luongtranpt/WSN/(list of files, drawings)

Other design files:
Hardware/Gateway_WSN_2023_1/Gateway_WSN_2023_1.PrjPcb
Hardware/Gateway_WSN_2023_1/HMI.SchDoc
Hardware/Gateway_WSN_2023_1/LORA.SchDoc
Hardware/Gateway_WSN_2023_1/MAIN.SchDoc
Hardware/Gateway_WSN_2023_1/MCU.SchDoc
Hardware/Gateway_WSN_2023_1/PCB2.PcbDoc
Hardware/Gateway_WSN_2023_1/POWER.SchDoc
Hardware/Node_WSN_2023_1/[1]MCU.SchDoc
Hardware/Node_WSN_2023_1/[3]SENSOR.SchDoc
Hardware/Node_WSN_2023_1/[4]LORA.SchDoc
Hardware/Node_WSN_2023_1/[5]LCD.SchDoc
Hardware/Node_WSN_2023_1/PCB1.PcbDoc
Hardware/Node_WSN_2023_1/PCB_Project.PrjPcb
Hardware/Node_WSN_2023_1/Sheet1.SchDoc
