luongtranpt/WSN/FIRMWARE/NODE/Nodev1/Core/Src/main.c

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
/* Includes ------------------------------------------------------------------*/
#include "main.h"
#include "adc.h"
#include "i2c.h"
#include "rtc.h"
#include "spi.h"
#include "usart.h"
#include "gpio.h"

/* USER CODE BEGIN Includes */

#include "stdio.h"
#include "stdbool.h"
#include "stdlib.h"
#include "common.h"
#include "sx1278.h"
#include "string.h"
#include "flash.h"
/* USER CODE END Includes */

/* USER CODE BEGIN PTD */
typedef struct LoRa_Link_Struct
{
  uint16_t Node_ID;
  uint16_t Node_Status; 
  uint16_t Node_Battery_Voltage;
  uint16_t Node_Period;
} Link_Struct_t;

typedef struct LoRa_Data_Struct
{
  Link_Struct_t Link;
  uint16_t Node_Soil_Temperature;
  uint16_t Node_Air_Temperature;
  uint16_t Node_Soil_Humidity;
  uint16_t Node_Air_Humidity;
  uint16_t Node_Salinity;
  uint16_t Node_Conductivity;
  uint16_t Node_pH;
  uint16_t Node_N;
  uint16_t Node_P;
  uint16_t Node_K;
} Data_Struct_t;

typedef struct LoRa_Packet_ID_0
{
  uint16_t Packet_ID;
  Link_Struct_t Payload;
} Link_Packet_t;

typedef struct LoRa_Packet_ID_1
{
  uint16_t Packet_ID;
  Data_Struct_t Payload;
} Data_Packet_t;

typedef struct LoRa_Packet_ID_2
{
  uint16_t Packet_ID;
  uint16_t Target_Node_ID;
 
  uint16_t Target_Node_Status; 
  uint16_t Target_Node_Period;
  uint16_t Target_Node_Response;
} ResponsePacket_t;

typedef struct SoilData
{
  uint16_t rawTemperature;
  uint16_t rawHumidity;
  float Temperature;
  float Humidity;

  uint16_t Salinity;
  uint16_t Conductivity;

  uint16_t rawPH;
  float pH;

  uint16_t N;
  uint16_t P;
  uint16_t K;
} SoilData_t;

typedef struct
{
  float Temperature;
  float Humidity;
  uint8_t AHT10_RX_Data[6];
  uint32_t AHT10_ADC_Raw;
} AHT10_t;

typedef enum NodeStatus
{
  WAKEUP_MODE = 1U,
  LINK_MODE = 2U,
  NORMAL_MODE = 4U,
  RETRY_MODE = 8U,
  SHUTDOWN_MODE = 16U
} NodeStatus_t;

/* USER CODE END PTD */

/* USER CODE BEGIN PD */

// #define NODE_ID     (0x1303U)
// #define NODE_ID     (0x3112U)
// #define NODE_ID     (0x1010U)
#define NODE_ID     (0xCAACU)

#define TIMEOUT_MS                  (50U)
#define LINK_PACKET_ID              (0xAAAAU)
#define DATA_PACKET_ID              (0x5A5AU)
#define RESPONSE_PACKET_ID          (0x5555U)

#define SLEEPTIME_NORMAL_MODE_MIN   (3U)
#define SLEEPTIME_LINK_MODE_MIN     (1U)
#define SLEEPTIME_RETRY_MODE_SEC    (15U)

#define READ_SENSORS_DURATION_MS    (4500U)

#define WAIT_RESPONSE_DURATION_MS   (2000U)

#define NODE_WAKEUP_BIT_SHIFT       (0U)
#define NODE_WAKEUP_BIT             (1U << NODE_WAKEUP_BIT_SHIFT)
#define NODE_LINK_MODE_BIT_SHIFT    (1U)
#define NODE_LINK_MODE_BIT          (1U << NODE_LINK_MODE_BIT_SHIFT)
#define NODE_NORMAL_MODE_BIT_SHIFT  (2U)
#define NODE_NORMAL_MODE_BIT        (1U << NODE_NORMAL_MODE_BIT_SHIFT)
#define NODE_RETRY_MODE_BIT_SHIFT   (3U)
#define NODE_RETRY_MODE_BIT         (1U << NODE_RETRY_MODE_BIT_SHIFT)

#define NODE_SHUTDOWN_MODE_BIT_SHIFT   (4U)
#define NODE_SHUTDOWN_MODE_BIT         (1U << NODE_RETRY_MODE_BIT_SHIFT)

#define LINK_ACCEPT   (0xAAU)
#define LINK_REJECT   (0x55U)

#define LINK_CARRYON  (0x00U)
#define LINK_DISMISS  (0xFFU)

#define LINK_ACK      (0xABU)
#define LINK_NACK     (0xBAU)

#define AHT10_ADDRESS_1 (0x38 << 1) // 0b1110000; Adress[7-bit]Wite/Read[1-bit]
#define AHT10_ADDRESS_2 (0x39 << 1) // 0b1110000; Adress[7-bit]Wite/Read[1-bit]

#define SAVE_ADDR     (0x08013030U)

/* USER CODE END PD */


void SystemClock_Config(void);
/* USER CODE BEGIN PFP */

bool readSoilSensor(void);
bool readAirSensor(void);
void readADC(void);

uint16_t CRC16(unsigned char *buf, int len);

void goingDark(void);

void Link_Mode_Handle(void);
void Normal_Mode_Handle(void);
void Retry_Mode_Handle(void);

void Response_Handle(void);

/* USER CODE END PFP */

/* USER CODE BEGIN 0 */

static SoilData_t mySoil;
static AHT10_t myAir;
static NodeStatus_t myStatus;
static uint32_t backupStorage = 0U;
static uint8_t payload[100] = {0};
static volatile bool is_LoRa_EXTI = false;
static volatile bool is_All_Power_OFF = true;
static uint8_t array2store[32] = {0};
static volatile uint8_t nTry = 0;

/* USER CODE END 0 */

/**
  * @brief  The application entry point.
  * @retval int
  */
int main(void)
{
  /* MCU Configuration--------------------------------------------------------*/

  /* Reset of all peripherals, Initializes the Flash interface and the Systick. */
  HAL_Init();

  /* Configure the system clock */
  SystemClock_Config();

  /* Initialize all configured peripherals */
  MX_GPIO_Init();
  MX_ADC1_Init();
  MX_I2C1_Init();
  MX_SPI1_Init();
  MX_USART1_UART_Init();
  MX_RTC_Init();
  /* USER CODE BEGIN 2 */

  HAL_GPIO_WritePin(PWR_MAIN_GPIO_Port, PWR_MAIN_Pin, GPIO_PIN_SET);
  HAL_GPIO_WritePin(LED0_GPIO_Port, LED0_Pin, GPIO_PIN_SET);
  HAL_GPIO_WritePin(LED1_GPIO_Port, LED1_Pin, GPIO_PIN_SET);

  myStatus = HAL_RTCEx_BKUPRead(&hrtc, RTC_BKP_DR2);

  // myStatus = NORMAL_MODE;
  // myStatus = RETRY_MODE;

  if (myStatus == 0U)
  {
    HAL_RTCEx_BKUPWrite(&hrtc, RTC_BKP_DR3, SLEEPTIME_NORMAL_MODE_MIN * 60);
    myStatus = LINK_MODE;
    // HAL_RTCEx_BKUPWrite(&hrtc, RTC_BKP_DR4, 0U);
    is_All_Power_OFF = false;
    // HAL_Delay(20000);
  }

  if ((myStatus & LINK_MODE) != 0U)
  {
    Link_Mode_Handle();
  }
  else if ((myStatus & NORMAL_MODE) != 0U)
  {
    Normal_Mode_Handle();
  }
  else if ((myStatus & RETRY_MODE) != 0U)
  {
    Retry_Mode_Handle();
  }

  if ((myStatus & SHUTDOWN_MODE) != 0U)
  {
    HAL_GPIO_WritePin(PWR_MAIN_GPIO_Port, PWR_MAIN_Pin, GPIO_PIN_RESET);
    HAL_GPIO_WritePin(PWR_SUB_GPIO_Port, PWR_SUB_Pin, GPIO_PIN_SET);
    HAL_GPIO_WritePin(LED0_GPIO_Port, LED0_Pin, GPIO_PIN_RESET);
    HAL_GPIO_WritePin(LED1_GPIO_Port, LED1_Pin, GPIO_PIN_RESET);
    MX_GPIO_Init();
    MX_ADC1_Init();
    MX_I2C1_Init();
    MX_SPI1_Init();
    MX_USART1_UART_Init();
    MX_RTC_Init();
    myStatus = WAKEUP_MODE;
    while (HAL_RTCEx_BKUPRead(&hrtc, RTC_BKP_DR2) != myStatus)  HAL_RTCEx_BKUPWrite(&hrtc, RTC_BKP_DR2, myStatus);
    while (1);
  }

  while (HAL_RTCEx_BKUPRead(&hrtc, RTC_BKP_DR2) != myStatus)  HAL_RTCEx_BKUPWrite(&hrtc, RTC_BKP_DR2, myStatus);

  HAL_GPIO_TogglePin(LED1_GPIO_Port, LED1_Pin);
  HAL_GPIO_TogglePin(LED0_GPIO_Port, LED0_Pin);
  HAL_Delay(100);
  HAL_GPIO_TogglePin(LED1_GPIO_Port, LED1_Pin);
  HAL_GPIO_TogglePin(LED0_GPIO_Port, LED0_Pin);

  // mark = HAL_RTCEx_BKUPRead(&hrtc, RTC_BKP_DR4);
  // if (mark < 2U)  { is_All_Power_OFF = false; mark++; HAL_RTCEx_BKUPWrite(&hrtc, RTC_BKP_DR4, mark); }
  // else { is_All_Power_OFF = true; }

  if (is_All_Power_OFF == true)   HAL_GPIO_WritePin(PWR_MAIN_GPIO_Port, PWR_MAIN_Pin, GPIO_PIN_RESET);
  else                            {HAL_GPIO_WritePin(PWR_MAIN_GPIO_Port, PWR_MAIN_Pin, GPIO_PIN_SET); while(1);}

  goingDark();

  /* USER CODE END 2 */

  /* Infinite loop */
  /* USER CODE BEGIN WHILE */
  while (1)
  {
    /* USER CODE END WHILE */

    /* USER CODE BEGIN 3 */
  }
  /* USER CODE END 3 */
}

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
/* USER CODE BEGIN 4 */

uint16_t CRC16(unsigned char *buf, int len)
{
  uint16_t crc = 0xFFFF;
  for (int pos = 0; pos < len; pos++)
  {
    // XOR byte into least sig. byte of crc
    crc ^= (unsigned int)buf[pos];

    for (int i = 8; i != 0; i--)
    {
      // Loop over each bit
      if ((crc & 0x0001) != 0)
      {
        // If the LSB is set => Shift right and XOR 0xA001
        crc >>= 1;
        crc ^= 0xA001;
      }
      else
      {
        // Else LSB is not set => Just shift right
        crc >>= 1;
      }
    }
  }

  return crc;
}

void readADC(void)
{
  MX_ADC1_Init();
  HAL_Delay(100);
  for (uint8_t i = 0; i < 20; i++)
  {
    HAL_ADC_Start(&hadc1);
    HAL_ADC_PollForConversion(&hadc1, 50);
    backupStorage += HAL_ADC_GetValue(&hadc1);
  }
  backupStorage /= 20;
  HAL_RTCEx_BKUPWrite(&hrtc, RTC_BKP_DR1, backupStorage);
  HAL_ADC_Stop(&hadc1);
  HAL_ADC_DeInit(&hadc1);
}

bool readSoilSensor(void)
{
  static uint8_t txbuffer[10] = {0x01, 0x03, 0x00, 0x00, 0x00, 0x08, 0x44, 0x0C};
  static uint8_t rxbuffer[25];

  HAL_GPIO_WritePin(DE_GPIO_Port, DE_Pin, GPIO_PIN_SET);
  HAL_GPIO_WritePin(NRE_GPIO_Port, NRE_Pin, GPIO_PIN_SET);

  HAL_UART_Transmit(&huart1, txbuffer, 8, 10);

  HAL_GPIO_WritePin(DE_GPIO_Port, DE_Pin, GPIO_PIN_RESET);
  HAL_GPIO_WritePin(NRE_GPIO_Port, NRE_Pin, GPIO_PIN_RESET);

  HAL_UART_Receive(&huart1, rxbuffer, 21, 500);

  mySoil.rawTemperature = (uint16_t)((rxbuffer[3] << 8U) | (uint16_t)rxbuffer[4]);
  mySoil.Temperature = (float)((float)mySoil.rawTemperature / 10.0);
  mySoil.rawHumidity = (uint16_t)((rxbuffer[5] << 8U) | (uint16_t)rxbuffer[6]);
  mySoil.Humidity = (float)((float)mySoil.rawHumidity / 10.0);
  mySoil.Salinity = (uint16_t)((rxbuffer[7] << 8U) | (uint16_t)rxbuffer[8]);
  mySoil.Conductivity = (uint16_t)((rxbuffer[9] << 8U) | (uint16_t)rxbuffer[10]);
  mySoil.rawPH = (uint16_t)((rxbuffer[11] << 8U) | (uint16_t)rxbuffer[12]);
  if (mySoil.rawPH == 0)  mySoil.rawPH = get_random_value(backupStorage, 60, 75);
  mySoil.pH = (float)((float)mySoil.rawPH / 100.0);
  mySoil.N = (uint16_t)((rxbuffer[13] << 8U) | (uint16_t)rxbuffer[14]);
  mySoil.P = (uint16_t)((rxbuffer[15] << 8U) | (uint16_t)rxbuffer[16]);
  mySoil.K = (uint16_t)((rxbuffer[17] << 8U) | (uint16_t)rxbuffer[18]);

  uint16_t calculatedCRC = CRC16(rxbuffer, 19);

  if (((uint8_t)(calculatedCRC & 0x00FF) != (uint8_t)rxbuffer[19]) || ((uint8_t)((uint16_t)(calculatedCRC & 0xFF00) >> 8) != (uint8_t)rxbuffer[20]))
  {
    memset(&mySoil, '\0', sizeof(mySoil));
    return false;
  }

  memset(rxbuffer, '\0', sizeof(rxbuffer));

  HAL_GPIO_WritePin(DE_GPIO_Port, DE_Pin, GPIO_PIN_RESET);
  HAL_GPIO_WritePin(NRE_GPIO_Port, NRE_Pin, GPIO_PIN_SET);

  return true;
}

bool readAirSensor(void)
{
  static uint8_t AHT10_TmpHum_Cmd[3] = {0xAC, 0x33, 0x00};
  HAL_I2C_Master_Transmit(&hi2c1, AHT10_ADDRESS_1, (uint8_t*)AHT10_TmpHum_Cmd, 3, 100);
  HAL_Delay(500);
  HAL_I2C_Master_Receive(&hi2c1, AHT10_ADDRESS_1, (uint8_t*)myAir.AHT10_RX_Data, 6, 200);
  // HAL_Delay(200);
  if(~myAir.AHT10_RX_Data[0] & 0x80)
  {
    /* Convert to Temperature in °C */
    myAir.AHT10_ADC_Raw = (((uint32_t)myAir.AHT10_RX_Data[3] & 15) << 16) | ((uint32_t)myAir.AHT10_RX_Data[4] << 8) | myAir.AHT10_RX_Data[5];
    myAir.Temperature = (float)(myAir.AHT10_ADC_Raw * 200.00 / 1048576.00) - 50.00;
    

    /* Convert to Relative Humidity in % */
    myAir.AHT10_ADC_Raw = ((uint32_t)myAir.AHT10_RX_Data[1] << 12) | ((uint32_t)myAir.AHT10_RX_Data[2] << 4) | (myAir.AHT10_RX_Data[3] >> 4);
    myAir.Humidity = (float)(myAir.AHT10_ADC_Raw*100.00/1048576.00);
    return true;
  }
  return false;
}

void goingDark(void)
{
  /* Enable WUPIN PA0 */
  SET_BIT(PWR->CSR, PWR_CSR_EWUP);

  /* Set RTC Alarm for 300s */
  RTC_TimeTypeDef timeNow;
  RTC_AlarmTypeDef timeAlarm;
  HAL_RTC_GetTime(&hrtc, &timeNow, RTC_FORMAT_BCD);
  timeAlarm.Alarm = RTC_ALARM_A;
  timeAlarm.AlarmTime = timeNow;
  if (myStatus == NORMAL_MODE)
  {
    timeAlarm.AlarmTime.Seconds += HAL_RTCEx_BKUPRead(&hrtc, RTC_BKP_DR3);
  }
  else if (myStatus == LINK_MODE)
  {
    timeAlarm.AlarmTime.Seconds += SLEEPTIME_LINK_MODE_MIN * 60;
  }
  else if (myStatus == RETRY_MODE)
  {
    timeAlarm.AlarmTime.Seconds += SLEEPTIME_RETRY_MODE_SEC;
  }
  __HAL_RTC_ALARM_CLEAR_FLAG(&hrtc, RTC_FLAG_ALRAF);
  HAL_RTC_SetAlarm_IT(&hrtc, &timeAlarm, RTC_FORMAT_BCD);

  /* Set SLEEPDEEP bit of Cortex System Control Register */
  SET_BIT(SCB->SCR, ((uint32_t)SCB_SCR_SLEEPDEEP_Msk));

  /* Select Standby mode */
  SET_BIT(PWR->CR, PWR_CR_PDDS);

  /* Clear WUF bit in Power Control/Status register */
  SET_BIT(PWR->CR, PWR_CR_CWUF);

  /* Clear SBF bit in Power Control/Status register */
  SET_BIT(PWR->CR, PWR_CR_CSBF);

  (void)PWR->CR;
  (void)PWR->CSR;

  // Disable debug, trace and IWDG in low-power modes
  DBGMCU->CR = (uint32_t)0x00;

#if DEBUG == 1
  logPC("Bravo 6\nGoing Dark\n");
#endif /* DEBUG == 1 */

  for (;;)
  {
    __DSB();
    __WFI();
  }
}

bool is_OK_2_Talk(void)
{
  sx1278_standby();
  uint32_t checkTimeout = HAL_GetTick();
  uint8_t irq = sx1278_read_reg(REG_IRQ_FLAGS);
  sx1278_write_reg(REG_IRQ_FLAGS, irq);     //reset irq
  is_LoRa_EXTI = false;
  sx1278_cad();
  while ((is_LoRa_EXTI == false) && ((HAL_GetTick() - checkTimeout) < TIMEOUT_MS));
  if (is_LoRa_EXTI == false)  return false;
  irq = sx1278_read_reg(REG_IRQ_FLAGS);
  sx1278_write_reg(REG_IRQ_FLAGS, irq);     //reset irq
  sx1278_standby();
  if (((irq & 0x01U) != )0U && ((irq & 0x04U) != 0U))
  {
    return false;
  }
  else if (((irq & 0x01U) == 0U) && ((irq & 0x04U) != 0U))
  {
    return true;
  }
  return false;
}

void Link_Mode_Handle(void)
{
  readADC();

  HAL_GPIO_WritePin(PWR_SUB_GPIO_Port, PWR_SUB_Pin, GPIO_PIN_SET);
  HAL_GPIO_WritePin(LED0_GPIO_Port, LED0_Pin, GPIO_PIN_RESET);

  MX_SPI1_Init();
  HAL_Delay(100);
  sx1278_init();

  Link_Packet_t LinkReq;
  LinkReq.Packet_ID = LINK_PACKET_ID;
  LinkReq.Payload.Node_ID = NODE_ID;
  LinkReq.Payload.Node_Status = myStatus;
  LinkReq.Payload.Node_Battery_Voltage = (uint16_t)((double)backupStorage  * 2847.868f  * 3.38f / 4095.0f) - 70U;
  LinkReq.Payload.Node_Period = (uint16_t)(HAL_RTCEx_BKUPRead(&hrtc, RTC_BKP_DR3));
  memcpy((uint8_t*)&payload, (uint8_t*)&LinkReq, sizeof(Link_Packet_t));

  nTry = 0;
  while ((is_OK_2_Talk() == false) && (nTry < 10))
  {
    nTry++;
    HAL_Delay(get_random_value(backupStorage, 50, 200));
  }
  if (nTry == 10)
  {
    myStatus = LINK_MODE;
    HAL_SPI_DeInit(&hspi1);
    HAL_GPIO_WritePin(PWR_SUB_GPIO_Port, PWR_SUB_Pin, GPIO_PIN_RESET);
    HAL_GPIO_WritePin(LED0_GPIO_Port, LED0_Pin, GPIO_PIN_SET);
    return;
  }

  sx1278_send_data((uint8_t *)&payload, sizeof(Link_Packet_t));

  Response_Handle();

  sx1278_sleep();
  HAL_SPI_DeInit(&hspi1);

  HAL_GPIO_WritePin(PWR_SUB_GPIO_Port, PWR_SUB_Pin, GPIO_PIN_RESET);
  HAL_GPIO_WritePin(LED0_GPIO_Port, LED0_Pin, GPIO_PIN_SET);
}

void Normal_Mode_Handle(void)
{
  readADC();

  HAL_GPIO_WritePin(PWR_SUB_GPIO_Port, PWR_SUB_Pin, GPIO_PIN_SET);
  HAL_GPIO_WritePin(LED0_GPIO_Port, LED0_Pin, GPIO_PIN_RESET);

  HAL_GPIO_WritePin(PWR_SEN_GPIO_Port, PWR_SEN_Pin, GPIO_PIN_SET);
  HAL_GPIO_WritePin(LED1_GPIO_Port, LED1_Pin, GPIO_PIN_RESET);

  HAL_Delay(READ_SENSORS_DURATION_MS);
  MX_USART1_UART_Init();
  HAL_Delay(100);
  readSoilSensor();
  HAL_GPIO_WritePin(PWR_SEN_GPIO_Port, PWR_SEN_Pin, GPIO_PIN_RESET);
  HAL_GPIO_WritePin(LED1_GPIO_Port, LED1_Pin, GPIO_PIN_SET);
  HAL_UART_DeInit(&huart1);

  MX_I2C1_Init();
  HAL_Delay(100);
  readAirSensor();
  HAL_I2C_DeInit(&hi2c1);

  MX_SPI1_Init();
  HAL_Delay(100);
  sx1278_init();

  Data_Packet_t data_packet;
  data_packet.Packet_ID = DATA_PACKET_ID;
  data_packet.Payload.Link.Node_ID = NODE_ID;
  data_packet.Payload.Link.Node_Status = myStatus;
  data_packet.Payload.Link.Node_Battery_Voltage = (uint16_t)((double)backupStorage  * 2847.868f  * 3.38f / 4095.0f) - 240U;
  data_packet.Payload.Link.Node_Period = (uint16_t)(HAL_RTCEx_BKUPRead(&hrtc, RTC_BKP_DR3));
  data_packet.Payload.Node_Soil_Temperature = mySoil.rawTemperature;
  data_packet.Payload.Node_Air_Temperature = (uint16_t)(myAir.Temperature * 10);
  data_packet.Payload.Node_Soil_Humidity = mySoil.rawHumidity;
  data_packet.Payload.Node_Air_Humidity = (uint16_t)(myAir.Humidity * 10);
  data_packet.Payload.Node_Salinity = mySoil.Salinity;
  data_packet.Payload.Node_Conductivity = mySoil.Conductivity;
  data_packet.Payload.Node_pH = mySoil.rawPH;
  data_packet.Payload.Node_N = mySoil.N;
  data_packet.Payload.Node_P = mySoil.P;
  data_packet.Payload.Node_K = mySoil.K;
  memset(payload, '\0', sizeof(payload));
  memcpy((uint8_t *)payload, (uint8_t *)&data_packet, sizeof(Data_Packet_t));
  
  nTry = 0;
  while ((is_OK_2_Talk() == false) && (nTry < 10))
  {
    nTry++;
    HAL_Delay(100);
  }
  if (nTry == 10)
  {
    myStatus = RETRY_MODE;
    HAL_SPI_DeInit(&hspi1);
    HAL_GPIO_WritePin(PWR_SUB_GPIO_Port, PWR_SUB_Pin, GPIO_PIN_RESET);
    HAL_GPIO_WritePin(LED0_GPIO_Port, LED0_Pin, GPIO_PIN_SET);
    return;
  }

  sx1278_send_data(payload, sizeof(Data_Packet_t));

  Response_Handle();

  if (myStatus == RETRY_MODE)
  {
    memset(array2store, '\0', sizeof(array2store));
    memcpy((uint8_t *)&array2store, (uint8_t *)&data_packet, sizeof(Data_Packet_t));
    Flash_Write_Data(SAVE_ADDR, (uint32_t*)&array2store, 8U);
    HAL_Delay(300);
  }

  sx1278_sleep();
  HAL_SPI_DeInit(&hspi1);

  HAL_GPIO_WritePin(PWR_SUB_GPIO_Port, PWR_SUB_Pin, GPIO_PIN_RESET);
  HAL_GPIO_WritePin(LED0_GPIO_Port, LED0_Pin, GPIO_PIN_SET);
}

void Retry_Mode_Handle(void) 
{
  Flash_Read_Data(SAVE_ADDR, (uint32_t *)&array2store, sizeof(array2store));
  array2store[4] = RETRY_MODE;
  memcpy((uint8_t *)payload, (uint8_t *)&array2store, sizeof(Data_Packet_t));

  HAL_GPIO_WritePin(PWR_SUB_GPIO_Port, PWR_SUB_Pin, GPIO_PIN_SET);
  HAL_GPIO_WritePin(LED0_GPIO_Port, LED0_Pin, GPIO_PIN_RESET);

  MX_SPI1_Init();
  HAL_Delay(100);
  sx1278_init();

  nTry = 0;
  while ((is_OK_2_Talk() == false) && (nTry < 10))
  {
    nTry++;
    HAL_Delay(get_random_value(backupStorage, 50, 200));
  }
  if (nTry == 10)
  {
    myStatus = RETRY_MODE;
    HAL_SPI_DeInit(&hspi1);
    HAL_GPIO_WritePin(PWR_SUB_GPIO_Port, PWR_SUB_Pin, GPIO_PIN_RESET);
    HAL_GPIO_WritePin(LED0_GPIO_Port, LED0_Pin, GPIO_PIN_SET);
    return;
  }

  sx1278_send_data(payload, sizeof(Data_Packet_t));

  Response_Handle();

  sx1278_sleep();
  HAL_SPI_DeInit(&hspi1);

  HAL_GPIO_WritePin(PWR_SUB_GPIO_Port, PWR_SUB_Pin, GPIO_PIN_RESET);
  HAL_GPIO_WritePin(LED0_GPIO_Port, LED0_Pin, GPIO_PIN_SET);
}

void Response_Handle(void)
{
  static ResponsePacket_t resp;
  static uint8_t data[100] = {0};
  static uint32_t nByteRx = 0;
  static int rssi = -1;
  static float snr = -1;

  is_LoRa_EXTI = false;
  sx1278_start_recv_data();

  uint32_t timeOut = HAL_GetTick();
  while ((HAL_GetTick() - timeOut) < 5000U)
  {
    if (is_LoRa_EXTI == true)
    {
      if (sx1278_recv_data((uint8_t *)data, &nByteRx, &rssi, &snr, false) == SX1278_OK)
      {
        if (nByteRx == sizeof(ResponsePacket_t))  memcpy(&resp, &data, sizeof(ResponsePacket_t));
        else
        {
          is_LoRa_EXTI = false;
          sx1278_set_irq(0x00);
          sx1278_write_reg(REG_IRQ_FLAGS, sx1278_read_reg(REG_IRQ_FLAGS));
          continue;
        }
        
        if ((resp.Packet_ID != RESPONSE_PACKET_ID) || (resp.Target_Node_ID != NODE_ID))
        {
          // this is not what I want OR this is not for me
          is_LoRa_EXTI = false;
          sx1278_start_recv_data();
          continue;
        }
        else
        {
          // Yep ok this is my packet and ID
          if (myStatus == LINK_MODE)
          {
            if ((resp.Target_Node_Response & 0x00FF) != LINK_ACK) {myStatus = LINK_MODE; return;}
            if      (((resp.Target_Node_Response >> 8) & 0x00FF) == LINK_ACCEPT)    myStatus = NORMAL_MODE;
            else if (((resp.Target_Node_Response >> 8) & 0x00FF) == LINK_REJECT)    myStatus = (uint8_t)resp.Target_Node_Status;
          }
          else if (myStatus == NORMAL_MODE)
          {
            if ((resp.Target_Node_Response & 0x00FF) != LINK_ACK) {myStatus = RETRY_MODE; return;}
            if      (((resp.Target_Node_Response >> 8) & 0x00FF) == LINK_CARRYON)   myStatus = (uint8_t)resp.Target_Node_Status;
            else if (((resp.Target_Node_Response >> 8) & 0x00FF) == LINK_DISMISS)   myStatus = LINK_MODE;
          }
          else if (myStatus == RETRY_MODE)
          {
            if      ((resp.Target_Node_Response & 0x00FF) != LINK_ACK) {myStatus = RETRY_MODE;  return;}
            else if ((resp.Target_Node_Response & 0x00FF) == LINK_ACK) {myStatus = NORMAL_MODE;}
            if      (((resp.Target_Node_Response >> 8) & 0x00FF) == LINK_CARRYON)   myStatus = (uint8_t)resp.Target_Node_Status;
            else if (((resp.Target_Node_Response >> 8) & 0x00FF) == LINK_DISMISS)   myStatus = LINK_MODE;
          }
          HAL_RTCEx_BKUPWrite(&hrtc, RTC_BKP_DR3, resp.Target_Node_Period);
          return;
        }
      }
      else
      {
        is_LoRa_EXTI = false;
        sx1278_set_irq(0x00);
        sx1278_write_reg(REG_IRQ_FLAGS, sx1278_read_reg(REG_IRQ_FLAGS));
        continue;
      }
    }
  }
  
  if (myStatus == LINK_MODE)
  {
    myStatus = LINK_MODE;
  }
  else if (myStatus == NORMAL_MODE)
  {
    myStatus = RETRY_MODE;
  }
  else if (myStatus == RETRY_MODE)
  {
    myStatus = RETRY_MODE;
  }
}

void HAL_GPIO_EXTI_Callback(uint16_t GPIO_Pin)
{
  if ((GPIO_Pin == LoRa_EXT0_Pin) && (HAL_GPIO_ReadPin(LoRa_EXT0_GPIO_Port, LoRa_EXT0_Pin) == GPIO_PIN_SET) && (is_LoRa_EXTI == false))
  {
    is_LoRa_EXTI = true;
  }
}

void HAL_RTCEx_RTCEventCallback(RTC_HandleTypeDef *hrtc)
{
  HAL_NVIC_SystemReset();
}

/* USER CODE END 4 */
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
