luongtranpt/WSN/FIRMWARE/GATEWAY/Gate_V1/hel/main/common.h

/**
 * @file common.h
 * @author Vanperdung (dung.nv382001@gmail.com)
 * @brief 
 * @version 0.1
 * @date 2023-02-09
 * 
 * @copyright Copyright (c) 2023
 * 
 */

#ifndef _COMMON_H_
#define _COMMON_H_

#include <math.h>
#include <stdint.h>
#include <string.h>
#include <stdbool.h>
#include <stdio.h>
#include <stdlib.h>

#define NORMAL_MODE 11
#define SMARTCONFIG_MODE 20
#define WIFI_SOFTAP_MODE 31

typedef enum
{
    LOCAL,
    NORMAL,
    CONFIG,
} gateway_mode_t;

typedef enum
{
    NOT_STATE,
    SMARTCONFIG,
    FOTA,
    WIFI_SOFTAP,
} gateway_cfg_mode_t;

typedef struct 
{
    char action[15];
} mqtt_obj_t;

esp_err_t mqtt_parse_data(char *mqtt_data, mqtt_obj_t *mqtt_obj);

#endif
