luongtranpt/WSN/(notices)

Notices in the files:
FIRMWARE/NODE/Nodev1/Core/Inc/main.h:
Copyright (c) 2023 STMicroelectronics.
All rights reserved.
This software is licensed under terms that can be found in the LICENSE file
